DTK-CreativeStudio/Drone2020/tanaka/z軸方向のドローンの位置制御(PID).pdf

令和 3 年 2 月 17 日

## PID 制御の実験

電 20-103 田中

たなか
裕

ゆう

1. P 制御のモデルづくり

今回用いる記号を以下に示す。

ｇ | ：重力加速度(Excel 計算上では 9.8[m/ s
| 2 ])
U | :ドローンのもつ総揚力[N]
ｍ | ：機体の質量[kg]
zr | ：現在の機体の原点からの z 軸(上下方向)の
変位[m]
zy ：機体の原点から上下向きの変位の目標値
[m]
Z0 | ：機体の最初の z 軸の原点からの変位。[m]
ｔ | ：時間[s]
e(t) ：制御偏差(ここではzy − zr[m])
u(t) ：操作量(ここでは U-mg[N])
φ | :機体座標系におけるロール角[°]
ψ | :機体座標系におけるヨー角[°]
Kp | :比例ゲイン
Kd | :微分ゲイン
Ki | :積分ゲイン
| ドローンに全く回転がかかっておらず、外乱
もなく、ドローンが上下方向にのみ移動すると仮
定する。この時、ニュートンオイラーの方程式よ
り、地上座標系 z 軸における運動は
mz̈= (cosφcosψ)U − mg | (1.1)

とあらわすことができる。また、今回、ドローン
は全く回転していないのでφ=ψ=0 となるため
mz̈= U − mg | (1.2)
と表せる。U – mg = u(t)と置くと

u(t) = m

∆z
∆t

2

(1.3)

と表せる。ここでΔz = e(t)とすると
比例定数Kpを用いて
u(t) = Kpe(t) | (1.3)
とあらわすことができる。
また、式(1.3)から、

Δz =

u(t)Δt

2 m | (1.4)

式(1.4)式を用いて操作量によって変動した値z’r は

z’r = z0 + Δz | (1.5)
となる。この z’rをもとに算出された e’(t)に基づ いて新たな操作量 u’(t)を作っていき、z 軸上の座 標の値をフィードバック制御する。(実際のz’rは
実測値を用いるが今回はシミュレーションのた
め式(1.5)を用いる。)
2. PD 制御のモデルづくり

PD 制御において操作量 u(t)は

u(t) = Kpe(t)–Kd

de(t) dt | (2.1)

とあらわされ、第二項は

Kd

de(t)
dt = Kd
e(t) − e(t − 1) Δt | (2.2)

と計算することができる。

3. PI 制御のモデルづくり

PI 制御において操作量 u(t)は
u(t) = Kpe(t) + Ki ∫ e(t)dt

t

0

(3.1)

とあらわされ、第二項は

Ki ∫ e(t)dt

t

0

= Ki(zy − zr)Δt (3.2)

## PID 制御の実験

電 20-103 田中

たなか
裕

ゆう

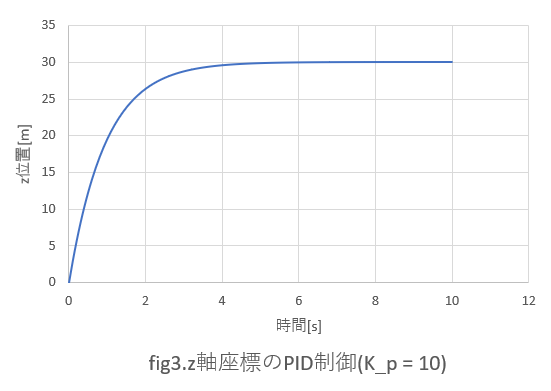
[picture p1: figure]

と計算することができる。

4.Excel を用いた実験

式(1.3)、(1.5)、(2.2)、(3.2)を基に Excel を用 いて実験する。この際、機体の重量は 1[kg]、重力 加速度は 9.8[m/s

2
]、目標値は 30[m]で計算した。
以下に実験結果を示す。

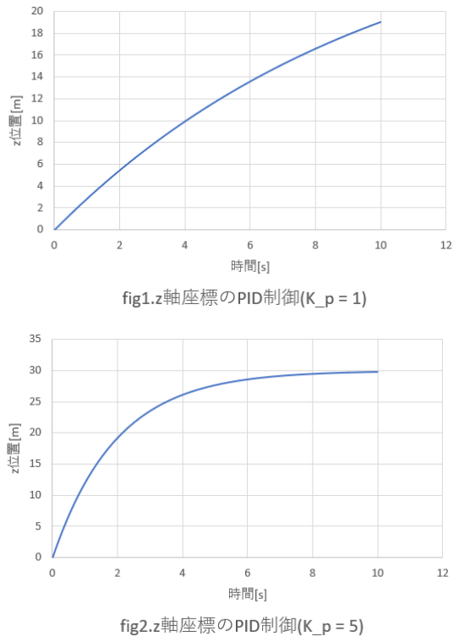
[picture p2: figure]

fig.1~3 のように p 制御だけでも比例ゲイン を大きくすればなんかいい感じに目標値(30[m])
に収束することがわかった。

## PID 制御の実験

電 20-103 田中

たなか
裕

ゆう
