DTK-CreativeStudio/Drone2020/report/R4.4.15(2).xlsx

Sheet: Sheet1
タイトル | 日付 | 実験開始時間 | LiPoの容量（初め）[%]
ゲイン調整してpid成功させよう実験 | 2022-04-15 |  | 74
 |  | 実験終了時間 | LiPoの容量（終わり）[%]
実験目的
ピッチ角の姿勢制御を可能にする
実験手順
実験用ソース（sheet）に示すプログラムで、4基モータ搭載時の挙動を調べる、ゲインはいじらず、ソースコードのthrottle部をいじっていく。
考察
次回の実験目的
今回の、最後に行った実験とゲイン設定を同じにして、実験装置の改良前後で、ピッチ角に違いが出るのかを観察して、pidが成功するように祈る

Sheet: 実験結果
回数 | target[°] | kp | ki | kd | 結果 | 考察 | 第一回 |  | 第二回 |  | 第三回 |  | 第四回 |  | 第五回
第1回 | 0 | 0.3 | 0 | 0 | アンダーシュートからのオーバーシュート | pゲインがそもそも大きすぎるのかも,あとオーバーシュートか単純な制御遅延かわからないからtargetをちょっと変えるべき,あと、明らかにtargetじゃないところで収束しているのでiゲインを入れる | time[ms] | pitch[°] | time[ms] | pitch[°] | time[ms] | pitch[°] | time[ms] | pitch[°] | time[ms] | pitch[°]
第2回 | -10 | 0.1 | 1 | 0 | いったんpゲインで持ち直そうとするが、積分でどんどんいってしまっている。 | iゲインの符号間違えちゃった | 0 | 0 | 0 | 0 | 0 | 0 | 0 | 0 | 0 | 0
第3回 | -10 | 0.1 | -1 | 0 | 振動しながら0に向かっていっている | 振動はとりあえずおいておいて、基準点を直そう。iゲインの調節によってtargetに基準点がくるようにするお。、あと、もしかするとzeroにあったのは出力不足説があるからlipoの容量を図ってみる。（53%だった） | 10 | -9 | 10 | -9 | 10 | -9 | 10 | -10 | 10 | -5
第4回 | -10 | 0.1 | -0.5 | 0 | いったん-10の点で泊まろうとするが、だんだん０点に移動してくる | 積分が後から効いた結果0に収束する可能性があるのでiゲインを減らしてみる | 20 | -9 | 20 | -9 | 20 | -9 | 20 | -10 | 20 | -5
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
