DTK-CreativeStudio/Drone2020/report/R4.4.20(1).xlsx

Sheet: Sheet1
タイトル | 日付 | 実験開始時間 | LiPoの容量（初め）[%]
装置ちょっといじってみたからそれ踏まえてまたやってみよう実験 | 2022-04-16 |  | 74
 |  | 実験終了時間 | LiPoの容量（終わり）[%]
実験目的
今回の、最後に行った実験とゲイン設定を同じにして、実験装置の改良前後で、ピッチ角に違いが出るのかを観察して、pidが成功するように祈る
実験手順
前回0点に収束したゲインを用いて装置改良前後の差を見ていく
考察
・機体の自重に推力が負けている説が濃厚
・モータ高出力時にモータ10が動作不良を起こすのはESCが原因だと判明
次回の実験目的
モータが高出力時でも異常が出なくなったので高出力時で機体の自重に耐えられるか検証する。

Sheet: 実験結果
回数 | base | target[°] | kp | ki | kd | 結果 | 考察 | 第一回 |  | 第二回 |  | 第三回 |  | 第四回 |  | 第五回
第1回 | 1300 | -10 | 0.1 | -0.2 | 0 | ０点で収束した | R4.4.15（2）の第五回に比べて早く収束した、ので、あまり機械による摩擦の効果はなかったと考える。なので、自重に負けて0に向かう説を担保するために出力をあげて実験してみる | time[ms] | pitch[°] | time[ms] | pitch[°] | time[ms] | pitch[°] | time[ms] | pitch[°] | time[ms] | pitch[°]
第2回 | 1400 | -10 | 0.1 | -0.2 | 0 | 0点で収束する時間が10倍ぐらいに伸びて、-5ぐらいを保持していた時間が１０秒くらいあった。 | 出力が機体の自重に負けている説が濃厚になってきた。ここからさらに出力を増やしていき、より時間が伸びるのか、また打ち勝つ時が来るのかを検証する。 | 0 | 0 | 0 | 0 | 0 |  | 0 | 0 | 0 | 0
第3回 | 1500 | -10 | 0.1 | -0.2 | 0 | 手前のモータがうまく動かなくなり発信した。 | 手前のモータ(6,10)のみが不調になっているが、ほかのモータは正常に動くので信号が高すぎて受け付けないことはないはず。よってモータのＥＳＣが原因であると考えＥＳＣを取り換えてみる。 | 10 | -5 | 10 | -8 | 10 |  | 10 | -10 | 10 | -5
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
