DTK-CreativeStudio/Drone2020/report/R4.4.21(1).xlsx

Sheet: Sheet1
タイトル | 日付 | 実験開始時間 | LiPoの容量（初め）[%]
モータをぶん回そう実験 | 2022-04-21 |  | 69
 |  | 実験終了時間 | LiPoの容量（終わり）[%]
実験目的
モータが高出力時でも異常が出なくなったので高出力時で機体の自重に耐えられるか検証する。
実験手順
モータの出力を上げて、ゲインを同じくして実験してみる。
考察
次回の実験目的
モータが高出力時でも異常が出なくなったので高出力時で機体の自重に耐えられるか検証する。

Sheet: 実験結果
回数 | base | max | min | target[°] | kp | ki | kd | 結果 | 考察 | 第一回 |  | 第二回 |  | 第三回 |  | 第四回 |  | 第五回
第1回 | 1500 | 1300 | 1700 | -10 | 0.1 | -0.2 | 0 | targetにとどまろうとめっちゃ頑張っていた。いったんtargetを通り過ぎてからまた戻ってくるなど激熱展開があった。 | 出力が自重に抵抗してることがよくわかる。Pidは結構成功してるっぽいから何ならスロットル初めてもいい気がする。 | time[ms] | pitch[°] | time[ms] | pitch[°] | time[ms] | pitch[°] | time[ms] | pitch[°] | time[ms] | pitch[°]
第2回 | 1700 | 1400 | 1900 | -10 | 0.1 | -0.2 | 0 | 負に発散した。 | 発散した直後奥側のモータ（9）が停止したことから、今回の上限出力であった1900にいきなり上がったことでモータが誤作動を起こしたと推定される。よって、次は上限を1800にして実験してみる。 | 0 | 0 | 0 |  | 0 |  | 0 | 0 | 0 | 0
第3回 | 1700 | 1400 | 1800 | -10 | 0.1 | -0.2 | 0 | 第二回同様に発散した。 | 上限を変えても発散したことから、いきなり1700に持って行ったことが今回のモータ不良の原因であると考えることができるので、baseを1600にしてみる. | 10 | 30 | 10 |  | 10 |  | 10 | -10 | 10 | -5
第4回 | 1600 | 1400 | 1800 | -10 | 0.1 | -0.2 | 0 | 第3回同様発信した。 | base1600もいきなりすぎたっぽいので1500に戻してゲイン調整で頑張ってみる。 | 20 | 30 | 20 |  | 20 |  | 20 | -10 | 20 | -5
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
