DTK-CreativeStudio/Drone2020/report/R4.5.18.xlsx

Sheet: Sheet1
タイトル | 日付 | 実験開始時間 | LiPoの容量（初め）[%]
姿勢制御頑張ろう実験 | 2022-05-18 |  | 69
 |  | 実験終了時間 | LiPoの容量（終わり）[%]
実験目的
モータの出力に対して軽めの機体（800gくらい）にしたのでもう一度実験してみる
実験手順
pidゲインによっての制御を試みる
考察
次回の実験目的

Sheet: 実験結果
回数 | base | max | min | target[°] | kp | ki | kd | 結果 | 考察 | 第一回 |  | 第二回 |  | 第三回 |  | 第四回 |  | 第五回
第1回 | 1500 | 1300 | 1700 | 0 | 3 | 1 | 0 | まず、targetにしっかり合わせることが大切であると判断 | まず、最後に入った値-6にすべてのターゲットを変更した結果行くのか（前回の敗因）、きちんとtargetごとに変わってくれるのかを検討 | time[ms] | pitch[°] | time[ms] | pitch[°] | time[ms] | pitch[°] | time[ms] | pitch[°] | time[ms] | pitch[°]
第2回 | 1500 | 1300 | 1700 | 10 | 0.1 | -0.2 | 0 | 負に発散した。 | 発散した直後奥側のモータ（9）が停止したことから、今回の上限出力であった1900にいきなり上がったことでモータが誤作動を起こしたと推定される。よって、次は上限を1800にして実験してみる。 | 0 | 0 | 0 |  | 0 |  | 0 |  | 0
第3回 | 1700 | 1400 | 1800 | -10 | 0.1 | -0.2 | 0 | 第二回同様に発散した。 | 上限を変えても発散したことから、いきなり1700に持って行ったことが今回のモータ不良の原因であると考えることができるので、baseを1600にしてみる. | 10 | 19 | 10 |  | 10 |  | 10 |  | 10
第4回 |  |  |  |  |  |  |  |  |  | 20 | 19 | 20 |  | 20 |  | 20 |  | 20
第5回 |  |  |  |  |  |  |  |  |  | 30 | 18 | 30 |  | 30 |  | 30 |  | 30
第6回 |  |  |  |  |  |  |  |  |  | 40 | 18 | 40 |  | 40 |  | 40 |  | 40
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
