DTK-CreativeStudio/Drone2020/report/R4.5.19.xlsx

Sheet: Sheet1
タイトル | 日付 | 実験開始時間
ゲインしっかり決めよう実験 | 2022-05-20
 |  | 実験終了時間
実験目的
限界感度法を用いることによってゲインを算出したい。
実験手順
まず、p制御のみで周期振動するようなKu（自分は10秒以上振動して勢いが落ちなければおkとしてる）を探す。その時の周期をPuとし、kp=0.6ku,ki=(0.6ku)/(0.5Pu),kd =(0.125Pu) (0.6ku)で算出
考察
次回の実験目的

Sheet: 実験結果
回数 | base | max | min | target[°] | kp | ki | kd | 結果 | 考察 | 18 |  | 19 |  | 第三回 |  | 第四回 |  | 第五回
第1回 | 1500 | 1300 | 1700 | 0 | 3 | 0 | 0 | 正に振りきれた | もうちょい落としてみる | time[ms] | pitch[°] | time[ms] | pitch[°] | time[ms] | pitch[°] | time[ms] | pitch[°] | time[ms] | pitch[°]
第2回 | 1500 | 1300 | 1700 | 0 | 1.5 | 0 | 0 | 正に振りきれた | もうちょい落としてみる | 0 | 0 | 0 | 0 | 0 | 0
第3回 | 1500 | 1300 | 1700 | 0 | 1 | 0 | 0 | 正に振りきれた | バッテリー切れ起こしてたw | 10 | 11 | 10 | 12 | 10 | 18
第4回 | 1500 | 1300 | 1700 | 0 | 1 | 0 | 0 | 正に振りきれた | もうちょい落としてみる | 20 | 11 | 20 | 12 | 20 | 17
第5回 | 1500 | 1300 | 1700 | 0 | 0.5 | 0 | 0 | 正に振りきれた | もうちょい落としてみる | 30 | 11 | 30 | 11 | 30 | 17
第6回 | 1500 | 1300 | 1700 | 0 | 0.3 | 0 | 0 | 正に振りきれた | もうちょい落としてみる | 40 | 10 | 40 | 11 | 40 | 17
第7回 | 1500 | 1300 | 1700 | 0 | 0.01 | 0 | 0 | 正に振りきれた | モータの回転向きがおかしいことが判明、ちょっと変えた | 50 | 10 | 50 | 11 | 50 | 16
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
