DTK-CreativeStudio/Drone2020/report/R4.5.24.xlsx

Sheet: 実験用ソース
第1回 | 2022-05-24
第2回
第3回
第4回
第5回
第6回
第7回
第8回
第9回
第10回
第11回
第12回
第13回
第14回
第15回
第16回
第17回
第18回
第19回
第20回

Sheet: Sheet1
タイトル | 日付 | 実験開始時間
ゲインしっかり決めよう実験 | 2022-05-24
 |  | 実験終了時間
実験目的
限界感度法をやってみたところなぜか小さいゲインでしか発振しなかった。というか大きいと一方に振り切れてしまった。このことからそもそもシステムが正帰還になっているんじゃねえかということになった
実験手順
rpmのプログラム部分の符号を逆にして検証
考察
次回の実験目的

Sheet: 実験結果
回数 | base | max | min | target[°] | kp | ki | kd | 結果 | 考察 | 1 |  | 2 |  | 第三回 |  | 4 |  | 5 |  | 6 |  | 6 |  | 7 |  | 12 |  | 12
第1回 | 1500 | 1300 | 1700 | 0 | 3 | 0 | 0 | 振動したが、持続振動ではなく、増幅振動となった | ゲインが大きすぎた。でもわりと持続に近いから2.なんぼくらいで行ける気がする | time[ms] |  | time[ms] |  | time[ms] |  | time[ms] | pitch[°] | time[ms] | pitch[°] | time[ms] |  | time[ms] |  | time[ms] |  | time[ms] |  | time[ms]
第2回 | 1500 | 1300 | 1700 | 0 | 2.7 | 0 | 0 | 多分持続振動になった | これからI,dのゲインを求めていく（限界感度法） ために周期を求める 振動時間を1000から3120とし、その間に波が5個入るので周期Puは0.424[s]となる kp=0.6Ku=1.62 ki = 1,62/(0.5Pu)=7.6415 kd=0.125Pu*kp=0.08586 | 0 | 0 | 0 | 0 | 0 | 0 | 0 | 0 | 0 | 0 | 0 | 0 | 0 | 0 | 0 | 0 | 0 | 0 | 0 | 0
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
