DTK-CreativeStudio/Drone2020/report/R4.5.28.xlsx

Sheet: 実験用ソース
第1回 | 2022-05-28
第2回
第3回
第4回
第5回
第6回
第7回
第8回
第9回
第10回
第11回
第12回
第13回
第14回
第15回
第16回
第17回
第18回
第19回
第20回

Sheet: Sheet1
タイトル | 日付 | 実験開始時間
ゲインしっかり決めよう実験 | 2022-05-28
 |  | 実験終了時間
実験目的
０はいい感じになったけど他がすべてゼロに収束するあの謎現象に陥ったので
実験手順
targetを変えてkp挙げて再挑戦する
考察
次回の実験目的
発振気味だったがたまに+5とかに止まっていたのでkd,kiの符号をせいにして2.4以下小数点を変えれば割かしうまくいきそうな気がする

Sheet: 実験結果
回数 | base | max | min | target[°] | kp | ki | kd | 結果 | 考察 | 1 |  | 第2回 |  | 3 |  | 4 |  | 5 |  | 6 |  | 7 |  | 8 |  | 9 |  |  |  | 14
第1回 | 1500 | 1300 | 1700 | -5 | 10 | 0 | 0 | 発振はしたが、所所モータが止まるような動作が見られ。きれいな発振にならなかった | kpが増えすぎてrpm値がリセットされてしまった | time[ms] |  | time[ms] |  | time[ms] |  | time[ms] | pitch[°] | time[ms] |  | time[ms] |  | time[ms] |  | time[ms] |  | time[ms] |  |  |  | time[ms]
第2回 |  |  |  |  | 5 |  |  | 単調増加していって最後にはモータが止まるような波形になっている | kp大きすぎ | 0 | 0 | 0 | 0 | 0 | 0 | 0 | 0 | 0 | 0 | 0 | 0 | 0 | 0 | 0 | 0 | 0 | 0 |  |  | 0 | 0
第3回 |  |  |  |  | 3 |  |  | 綺麗に発振してきた | 半分にする（でもこれだと前とゲイン変わらんけど大丈夫か？） | 10 | 12 | 10 | 13 |  | 15 | 10 | 15 | 10 | 13 | 10 | 17 | 10 | 15 | 10 | 11 | 10 | 19 |  |  | 10 | 14
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
