DTK-CreativeStudio/Drone2020/report/R4.6.2.xlsx

Sheet: 実験用ソース
第1回 | 2022-05-28
第2回
第3回
第4回
第5回
第6回
第7回
第8回
第9回
第10回
第11回
第12回
第13回
第14回
第15回
第16回
第17回
第18回
第19回
第20回

Sheet: Sheet1
タイトル | 日付 | 実験開始時間
ゲインしっかり決めよう実験 | 2022-06-03 | 74%
 |  | 実験終了時間
実験目的
発振気味だったがたまに+5とかに止まっていたのでkd,kiの符号をせいにして2.4以下小数点を変えれば割かしうまくいきそうな気がする
実験手順
5.28のkiとkdのみを反転させてやってみる
考察
次回の実験目的

Sheet: 実験結果
回数 | base | max | min | target[°] | kp | ki | kd | 結果 | 考察 | 1 |  | 第2回 |  | 4 |  | 4 |  | 7 |  | 6 |  | 7 |  | 8 |  | 9
第1回 | 1500 | 1300 | 1700 | -5 | 1.5 | 10 | 2.4 | いったんどっか行ってからすごいいい感じに5あたりにとどまった。 | まずkiとkdの符号に関しては5.28のままでよかった。戻してもう一回 | time[ms] |  | time[ms] |  | time[ms] |  | time[ms] |  | time[ms] |  | time[ms] |  | time[ms] |  | time[ms] |  | time[ms]
第2回 | 1500 | 1300 | 1700 | -5 | 1.5 | -10 | -2.4 | 0に戻ってきやがった。明らかに+-で、止まりやすさが違う。 | いったん、targetを+にしてやってみる | 0 | 0 | 0 | 0 | 0 | 0 | 0 | 0 | 0 | 0 | 0 | 0 | 0 | 0 | 0 | 0 | 0 | 0
第3回 | 1500 | 1300 | 1700 | 5 | 1.5 | -10 | -2.4 | おなじようにすぐ戻ってきた | ということは、-+では関係なく、単純に第一回でやったゲインが神ってただけっぽいので、第一回のやつの再現性をとってみる | 10 | 12 | 10 | 11 |  | 9 | 10 | 8 | 10 | 9 | 10 | 12 | 10 | 15 | 10 | 11 | 10 | 19
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
