DTK-CreativeStudio/Drone2020/report/R4.6.3.xlsx

Sheet: 実験用ソース
第1回 | 2022-05-28
第2回
第3回
第4回
第5回
第6回
第7回
第8回
第9回
第10回
第11回
第12回
第13回
第14回
第15回
第16回
第17回
第18回
第19回
第20回

Sheet: Sheet1
タイトル | 日付 | 実験開始時間
積分プログラム直したからもっかいやってみよう実験 | 2022-06-03 | 74%
 |  | 実験終了時間
実験目的
積分プログラム直したらなんかうまくいったので、これからそれのブラッシュアップをします
実験手順
5.28のkiとkdのみを反転させてやってみる
考察
次回の実験目的

Sheet: 実験結果
回数 | base | max | min | target[°] | kp | ki | kd | 結果 | 考察 | 1 |  | 第3回 |  | 5 |  |  |  | 8 |  | 9
第1回 | 1500 | 1300 | 1700 | 15 | 2 | 18 | 0 | できた！！ | 次はdゲインによって外乱から立ち上がりまでの時間を短くしてみる7 | time[ms] |  | time[ms] |  | time[ms] |  |  |  | time[ms] |  | time[ms]
第2回 | 1500 | 1300 | 1700 | 15 | 2 | 18 | -0.1 | 0から動かんくなった | dゲイン効きすぎ | 0 | 0 | 0 | 0 | 0 | 0 |  |  | 0 | 0 | 0 | 0
第3回 | 1500 | 1300 | 1700 | 15 | 2 | 18 | -0.01 | 明らかに収束までが短くなったし、1waveで終わってる | もうちょい増やしてみる | 10 | 10 | 10 | 10 |  | 10 |  |  | 10 | 11 | 10 | 19
第4回 | 1500 | 1300 | 1700 | 15 | 2 | 18 | -0.01 | 明らかに収束までが短くなったし、1waveで終わってる | インパルスが結構しっかり出てしまうからそれを直してみる(kiを下げる) | 20 | 10 | 20 | 10 |  | 10 |  |  | 20 | 11 | 20 | 19
第5回 | 1500 | 1300 | 1700 | 15 | 2 | 7 | -0.01 |  |  | 30 | 10 | 30 | 10 | 30 | 10 |  |  | 30 | 10 | 30 | 19 | 30 | 15
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
