DTK-CreativeStudio/Drone2020/report/R4.4.15(姿勢制御).xlsx

Sheet: Sheet1
タイトル | 日付 | 実験開始時間 | LiPoの容量（初め）[%]
なんでモータ動かんくなってんねん検証 | 2022-04-15 |  | 71
 |  | 実験終了時間 | LiPoの容量（終わり）[%]
実験目的
モータが動かなくなった原因を探る
実験手順
実験用ソース（sheet）に示すプログラムで、4基モータ搭載時の挙動を調べる、ゲインはいじらず、ソースコードのthrottle部をいじっていく。
考察

Sheet: 実験結果
回数 | 手法 | 結果 | 考察
第1回 | 昨日までのプログラムR4.4.15(1)で、動作実験をする | 今までは、スイッチを入れても「ピピぴっ」しか言わずそのあとの「ぴっぴっぴ」はシリアルモニタを起動しないと言わなかったが、今回はスイッチを入れた段階で言っていた。何ならPCにarduinoをつないでないのに言ってた。 ジャイロセンサの角度はきっちり読み取れている。 | ソースがおかしい？
第2回 | 上記プログラムのthrotteをforループで動かすところを変更した | 回りましたが、ちょっとで止まった | ほぼ確実にソースが原因だと分かった
第3回 | 上記のrpmを規格化する（(rpm <= -1 || 200 <= rpm){）のところを-1を-200に直した | 変わらんかった | すぐ回って止まるってことは、for文が機能していてその次がないってことだと思うので、for文以下をいじってみよう
第4回
第5回 | 昨日までのプログラムR4.4.15(5)で、動作実験をする
第6回 | 昨日までのプログラムR4.4.15(6)で、動作実験をする
第7回 | 昨日までのプログラムR4.4.15(7)で、動作実験をする
第8回 | 昨日までのプログラムR4.4.15(8)で、動作実験をする
第9回 | 昨日までのプログラムR4.4.15(9)で、動作実験をする
第10回
第11回
第12回
第13回
第14回
第15回
第16回
第17回
第18回
第19回
第20回

Sheet: 実験用ソース
第1回 | R4.4.15(1)
第2回
第3回
第4回
第5回
第6回
第7回
第8回
第9回
第10回
第11回
第12回
第13回
第14回
第15回
第16回
第17回
第18回
第19回
第20回
