DTK-CreativeStudio/Drone2020/tanaka/R3.8.20_pitch_control/R3.8.20_pitch_control.ino

#include <Wire.h>
#include <SPI.h>
#include <SparkFunLSM9DS1.h>
float first_heading = 1.;
float heading = NULL;
//////////////////////////
// LSM9DS1 Library Init //
//////////////////////////
// Use the LSM9DS1 class to create an object. [imu] can be
// named anything, we'll refer to that throught the sketch.
LSM9DS1 imu;

///////////////////////
// Example I2C Setup //
///////////////////////
// SDO_XM and SDO_G are both pulled high, so our addresses are:
// #define LSM9DS1_M  0x1E // Would be 0x1C if SDO_M is LOW
// #define LSM9DS1_AG 0x6B // Would be 0x6A if SDO_AG is LOW

////////////////////////////
// Sketch Output Settings //
////////////////////////////
#define PRINT_CALCULATED
//#define PRINT_RAW
#define PRINT_SPEED 5 // 250 ms between prints
static unsigned long lastPrint = 0; // Keep track of print time

// Earth's magnetic field varies by location. Add or subtract
// a declination to get a more accurate heading. Calculate
// your's here:
// http://www.ngdc.noaa.gov/geomag-web/#declination
#define DECLINATION -8.58 // Declination (degrees) in Boulder, CO.

//Function definitions
void printGyro();
void printAccel();
void printMag();
void printAttitude(float ax, float ay, float az, float mx, float my, float mz);

void setup()
{
  Serial.begin(115200);

  Wire.begin();

  if (imu.begin() == false) // with no arguments, this uses default addresses (AG:0x6B, M:0x1E) and i2c port (Wire).
  {
    Serial.println("Failed to communicate with LSM9DS1.");
    Serial.println("Double-check wiring.");
    Serial.println("Default settings in this sketch will " \
                   "work for an out of the box LSM9DS1 " \
                   "Breakout, but may need to be modified " \
                   "if the board jumpers are.");
    while (1);
  }
}

void loop()
{
  // Update the sensor values whenever new data is available
  if ( imu.gyroAvailable() )
  {
    // To read from the gyroscope,  first call the
    // readGyro() function. When it exits, it'll update the
    // gx, gy, and gz variables with the most current data.
    imu.readGyro();
  }
  if ( imu.accelAvailable() )
  {
    // To read from the accelerometer, first call the
    // readAccel() function. When it exits, it'll update the
    // ax, ay, and az variables with the most current data.
    imu.readAccel();
  }
  if ( imu.magAvailable() )
  {
    // To read from the magnetometer, first call the
    // readMag() function. When it exits, it'll update the
    // mx, my, and mz variables with the most current data.
    imu.readMag();
  }

  if ((lastPrint + PRINT_SPEED) < millis())
  {
    printAttitude(imu.ax, imu.ay, imu.az,
                  -imu.my, -imu.mx, imu.mz);
    Serial.println();

    lastPrint = millis(); // Update lastPrint time
  }
}


void printAttitude(float ax, float ay, float az, float mx, float my, float mz)
{
  float roll = atan2(ay, az);
  float pitch = atan2(-ax, sqrt(ay * ay + az * az));
  if(heading != NULL){
  if (my == 0)
    heading = (mx < 0) ? PI : 0;
  else
    heading = atan2(mx, my);
    }
  else{
    
      if (my == 0)
        heading = (mx < 0) ? PI : 0;
      else
        heading = atan2(mx, my);
      heading -= DECLINATION * PI / 180;
      heading *= 180.0 / PI;
      first_heading = heading;
    }
  heading -= DECLINATION * PI / 180;

  if (heading > PI) heading -= (2 * PI);
  else if (heading < -PI) heading += (2 * PI);

  // Convert everything from radians to degrees:
  heading *= 180.0 / PI;
  pitch *= 180.0 / PI;
  roll  *= 180.0 / PI;
  if(first_heading >= 0)
    heading += first_heading;
  else
    heading -= first_heading;

  Serial.print(pitch, 0);
  Serial.print(", ");
  Serial.print(roll, 0);
  Serial.print(", ");
  Serial.println(heading, 0);

}
