DTK-CreativeStudio/Drone2020/(commit log)

2020-11-21 readme増やした
2020-11-22 11/21活動報告
2020-11-22 ああああ
2020-11-22 11/22変更分
2020-11-23 11/23田中変更分
2020-11-23 11/23変更分
2020-11-23 11/23報告分
2020-11-24 11/24田中変更分
2020-11-24 11/24(月)変更分
2020-11-25 11/25田中変更分
2020-11-26 11/27田中変更分
2020-11-30 11/30田中変更分
2020-11-30 11/30変更分
2020-12-03 12/3田中変更分
2020-12-12 12/12田中変更
2020-12-12 12/12田中変更分
2021-02-17 田中2/17変更分
2021-02-17 2/17田中変更分
2021-02-20 2/20田中変更分
2021-03-29 3/29田中変更分
2021-03-29 田中3/29変更分
